qkrehdud11-blip/Balancing_Robot/mpu6050_report.html

# MPU6050 IMU 센서 기술 보고서

Balancing Robot Project — Basys3 FPGA (Xilinx) / Verilog HDL

InvenSense MPU-6050 · 6-Axis IMU · I²C Interface

### 목차

1. MPU6050 개요 및 주요 사양
2. 감도(Sensitivity)와 16384의 근거
3. 가속도계 데이터 해석
4. 자이로스코프 데이터 해석
5. I²C 통신 및 레지스터 맵
6. 초기화 시퀀스
7. 프로젝트 적용 현황
8. 현재 데이터 진단

## 1 MPU6050 개요 및 주요 사양

MPU6050은 InvenSense(현 TDK)에서 제조한 6축 IMU(Inertial Measurement Unit) 센서입니다. 3축 가속도계와 3축 자이로스코프를 하나의 패키지에 통합하고, I²C 인터페이스로 마이크로컨트롤러/FPGA와 통신합니다.

16-bit

ADC 해상도

400kHz

I²C 최대 속도

3.3V

동작 전압

6축

가속도 + 자이로

0x68

기본 I²C 주소

±2g~±16g

가속도 레인지

### 핀 구성

핀 | 이름 | 설명
VCC | 전원 | 3.3V (브레이크아웃 보드는 5V도 가능)
GND | 접지 | 공통 GND
SCL | I²C Clock | I²C 클럭 (풀업 4.7kΩ 필요)
SDA | I²C Data | I²C 데이터 (풀업 4.7kΩ 필요)
AD0 | 주소 선택 | GND → 0x68 / VCC → 0x69
INT | 인터럽트 | 데이터 레디 신호 (이 프로젝트 미사용)
XDA, XCL | 보조 I²C | 외부 센서 연결용 (미사용)

## 2 감도(Sensitivity)와 16384의 근거

MPU6050의 가속도계는 16비트 부호있는 정수(signed 16-bit)로 값을 출력합니다. 이 숫자가 실제 물리량(g)으로 변환되는 비율을 감도(Sensitivity Scale Factor)라고 합니다.

### 계산 원리

16-bit signed 정수 범위 : -32768 ~ +32767

양의 최대값 = 2^15 = 32768

±2g 레인지 선택 시:

Sensitivity = 32768 ÷ 2 (g) = 16384 LSB/g

→ 1g(중력가속도)가 인가되면 ADC 출력 = 16384

// LSB = Least Significant Bit, 즉 최솟값 1단위

### 레인지별 감도 비교

가속도 레인지 | Sensitivity | ACCEL_CONFIG
±2g (기본값) | 16384 LSB/g | AFS_SEL = 0b00
±4g | 8192 LSB/g | AFS_SEL = 0b01
±8g | 4096 LSB/g | AFS_SEL = 0b10
±16g | 2048 LSB/g | AFS_SEL = 0b11

자이로 레인지 | Sensitivity | GYRO_CONFIG
±250°/s (기본값) | 131 LSB/°/s | FS_SEL = 0b00
±500°/s | 65.5 LSB/°/s | FS_SEL = 0b01
±1000°/s | 32.8 LSB/°/s | FS_SEL = 0b10
±2000°/s | 16.4 LSB/°/s | FS_SEL = 0b11

결론: 이 프로젝트는 ACCEL_CONFIG/GYRO_CONFIG를 설정하지 않아 기본값 사용 중.
가속도 ±2g → Sensitivity = 16384 LSB/g
자이로 ±250°/s → Sensitivity = 131 LSB/(°/s)

### 실제값 변환 공식

실제 가속도 (g) = ADC값 ÷ 16384

실제 각속도 (°/s) = ADC값 ÷ 131

예시: AZ = 16120 → 16120 ÷ 16384 ≈ 0.984g (평지 기준 약 1g, 정상)

예시: GX = 131 → 131 ÷ 131 ≈ 1.0°/s

## 3 가속도계 데이터 해석

가속도계는 중력(g)을 포함한 선형 가속도를 측정합니다. 정지 상태에서도 중력(1g)이 측정되므로, 이를 기준으로 자세를 판단할 수 있습니다.

### 평지 정치 시 이상값

상태 | AX | AY | AZ | 설명
평지 정치 (이상) | 0 | 0 | +16384 | 중력이 Z축 방향으로만 작용
X축으로 5° 기울음 | ±1428 | ~0 | ~16320 | sin(5°)×16384 ≈ 1428
X축으로 90° 기울음 | ±16384 | ~0 | ~0 | 중력이 X축 방향으로 작용
완전히 뒤집힘 | ~0 | ~0 | -16384 | 중력이 -Z 방향
자유낙하 | 0 | 0 | 0 | 무중력 상태 (모든 축 0)

### 기울기 각도 계산

θ_x = arctan(AX / AZ) × (180 / π)

θ_y = arctan(AY / AZ) × (180 / π)

예시: AX=1471, AZ=16120

θ_x = arctan(1471 / 16120) = arctan(0.0912) ≈ 5.2°

// 가속도계만으로 계산한 각도 → 노이즈에 민감하므로 자이로와 상호 보완 필요

## 4 자이로스코프 데이터 해석

자이로스코프는 각속도(°/s, degree per second)를 측정합니다. 정지 상태에서는 0에 가까운 값이 나와야 하며, 회전 중에는 회전 속도에 비례한 값이 출력됩니다.

131

LSB per °/s (±250°/s)

±250°/s

기본 측정 범위

~50

정지 시 허용 노이즈 (LSB)

### 가속도계 vs 자이로스코프 비교

항목 | 가속도계 | 자이로스코프
측정 대상 | 선형 가속도 (중력 포함) | 각속도 (회전 속도)
정지 시 | AZ ≈ 16384 (중력), AX/AY ≈ 0 | GX/GY/GZ ≈ 0
장점 | 절대 각도 계산 가능 (중력 기준) | 빠른 응답, 단기 정확도 높음
단점 | 진동·충격에 민감, 노이즈 큼 | 드리프트(시간 지남에 따라 오차 누적)
균형 로봇 사용 | 기준 각도 보정용 | 실시간 각속도 제어용

균형 로봇 제어 전략: 가속도계 각도(절대 기준) + 자이로 각속도(빠른 반응)를 상보 필터(Complementary Filter) 또는 칼만 필터로 융합하여 안정적인 각도 추정이 필요합니다.

## 5 I²C 통신 및 레지스터 맵

MPU6050은 I²C 슬레이브로 동작합니다. AD0 핀 레벨로 주소가 결정되며, 이 프로젝트에서는 AD0=GND(0x68)를 사용합니다.

### I²C 주소

7-bit 주소: 0x68 (AD0=GND) / 0x69 (AD0=VCC)

쓰기 주소 (8-bit): 0xD0 → { 0x68, 1'b0 }

읽기 주소 (8-bit): 0xD1 → { 0x68, 1'b1 }

### 주요 레지스터 맵

주소 | 레지스터명 | 기본값 | 설명
0x19 | SMPLRT_DIV | 0x00 | 샘플링 레이트 분주기 (기본: 8kHz÷1 = 8kHz)
0x1A | CONFIG | 0x00 | DLPF(디지털 저역 통과 필터) 설정
0x1B | GYRO_CONFIG | 0x00 | 자이로 레인지: 0x00=±250°/s
0x1C | ACCEL_CONFIG | 0x00 | 가속도 레인지: 0x00=±2g
0x3B | ACCEL_XOUT_H | - | 가속도 X축 상위 바이트 (burst read 시작점)
0x3C | ACCEL_XOUT_L | - | 가속도 X축 하위 바이트
0x3D~0x40 | ACCEL_Y/Z | - | 가속도 Y, Z축 (각 2바이트)
0x41~0x42 | TEMP_OUT | - | 온도 센서 (이 프로젝트 미사용)
0x43~0x48 | GYRO_X/Y/Z | - | 자이로 X, Y, Z축 (각 2바이트)
0x6B | PWR_MGMT_1 | 0x40 | 슬립 모드 제어. 기본값 0x40=슬립 ON → 0x00으로 초기화 필요
0x75 | WHO_AM_I | 0x68 | 칩 ID 확인용 (항상 0x68 반환)

### Burst Read 순서 (0x3B~0x48, 14바이트)

Byte 0: ACCEL_XOUT_H │ Byte 1: ACCEL_XOUT_L → AX = {Byte0, Byte1}

Byte 2: ACCEL_YOUT_H │ Byte 3: ACCEL_YOUT_L → AY = {Byte2, Byte3}

Byte 4: ACCEL_ZOUT_H │ Byte 5: ACCEL_ZOUT_L → AZ = {Byte4, Byte5}

Byte 6: TEMP_OUT_H │ Byte 7: TEMP_OUT_L → (skip)

Byte 8: GYRO_XOUT_H │ Byte 9: GYRO_XOUT_L → GX = {Byte8, Byte9}

Byte 10: GYRO_YOUT_H │ Byte 11: GYRO_YOUT_L → GY = {Byte10,Byte11}

Byte 12: GYRO_ZOUT_H │ Byte 13: GYRO_ZOUT_L → GZ = {Byte12,Byte13}

## 6 초기화 시퀀스

MPU6050은 기본적으로 슬립(Sleep) 모드로 부팅됩니다. 반드시 PWR_MGMT_1 레지스터를 0x00으로 설정해 슬립을 해제해야 데이터가 출력됩니다.

### 최소 초기화 (현재 프로젝트)

① 전원 인가 후 50ms 이상 대기

② I²C Write: 0x6B (PWR_MGMT_1) ← 0x00 // 슬립 해제, 내부 8MHz 클럭 사용

③ 이후 0x3B부터 14바이트 Burst Read 반복

### 권장 추가 초기화 (선택)

순서 | 레지스터 | 값 | 효과
1 | 0x6B | 0x00 | 슬립 해제 (필수)
2 | 0x1A | 0x03 | DLPF 활성화 (44Hz 차단, 노이즈 감소)
3 | 0x19 | 0x04 | 샘플레이트 200Hz (DLPF ON 시 1kHz÷(4+1))
4 | 0x1B | 0x08 | 자이로 레인지 ±500°/s (균형 로봇에 더 적합)

⚠ DLPF 추천: 균형 로봇은 모터 진동이 심합니다. DLPF(CONFIG=0x03, 44Hz 차단주파수)를 설정하면 고주파 노이즈가 크게 줄어 PID 제어가 안정적으로 됩니다.

## 7 프로젝트 적용 현황

### 모듈 구조

모듈 | 파일 | 역할 | 상태
I²C 마스터 | i2c_master.v | Write/Burst Read FSM, ACK/NACK 처리 | 완성
MPU 제어 | mpu6050_ctrl.v | 초기화 → 14byte Burst Read → 6축 파싱 | 완성
UART 디버그 | mpu6050_debug_uart.v | 10진수 부호 포함 포맷으로 PC 출력 (1Hz) | 완성
Bias 보정 | top.v | 256 샘플 평균으로 AX/AY/GX/GY/GZ bias 제거 | 완성
각도 계산 | angle_calc.v | accel+gyro 융합 각도 추정 | 미구현

### I²C 타이밍 (현재 설정)

tick 주기: 0.5ms (clk_divider, 2kHz)

I²C SCL: 각 상태 1 tick → SCL ≈ 1kHz

MPU6050 최대 I²C: 400kHz → 현재 1kHz는 충분히 안전

데이터 읽기 주기: 1000 tick × 0.5ms = 500ms (2Hz)

UART 출력 주기: 1초 (1Hz)

### Bias 교정 소요 시간

data_valid 주기: 500ms

교정 샘플 수: 256개

교정 완료 시간: 256 × 500ms = 128초 (약 2분 10초)

// led[2] (bias_done) 켜질 때까지 대기 필요

### 핀 할당

신호 | FPGA 핀 | Basys3 위치
i2c_sda | K17 | JC 헤더 JC1
i2c_scl | M18 | JC 헤더 JC2
uart_tx (PC) | A18 | USB-RS232 직결
reset | U18 | BTNC (중앙 버튼)

## 8 현재 데이터 진단

현재 moserial에서 확인된 값: AX=+01471 AY=? AZ=+16120 GX≈0 GY≈0 GZ≈0

AZ = 16120 — 정상. 이상값 16384 대비 오차 264 LSB ≈ 0.016g (공장 오차 수준)

GX/GY/GZ ≈ 0 — 정상. 정지 상태에서 각속도 0에 수렴

AX = 1471 — 확인 필요. 아래 원인 중 하나

가능한 원인 | 확인 방법 | 해결
Bias 교정 미완료 (2분 미경과) | led[2] (bias_done) 꺼져 있음 | Reset 후 2분 이상 평지에서 대기
실제 5° 기울어진 상태 | 보드를 수평계로 확인 | MPU6050 장착 각도 수정
교정 중 기울어져 있었음 | Reset 후 평지에서 재교정 | 평지 고정 후 Reset

⚠ 빠른 교정 확인 방법:
mpu6050_ctrl.v의 READ_PERIOD_TICKS를 100으로 줄이면 교정 시간이 128초 → 약 13초로 단축됩니다.

### 균형 로봇 목표값

조건 | AX 목표 | AZ 목표 | 의미
로봇 직립 균형 | ≈ 0 | ≈ 16384 | 완전 수직 상태
PID 에러 입력 | error = AX_measured - 0 | | AX가 PID setpoint 편차
모터 구동 임계 | |AX| > 200 | - | 이보다 크면 모터 보정 개입

MPU6050 기술 보고서 · Balancing Robot Project (Basys3 FPGA) · 2026-04-15
InvenSense MPU-6050 Product Specification Rev 3.4 기준
