qkrehdud11-blip/Balancing_Robot/Balacing_Robot.srcs/sources_1/new/l298n.v

`timescale 1ns / 1ps
//////////////////////////////////////////////////////////////////////////////////
// Company: 
// Engineer: 
// 
// Create Date: 04/12/2026 11:40:38 PM
// Design Name: 
// Module Name: l298n
// Project Name: 
// Target Devices: 
// Tool Versions: 
// Description: 
// 
// Dependencies: 
// 
// Revision:
// Revision 0.01 - File Created
// Additional Comments:
// 
//////////////////////////////////////////////////////////////////////////////////


module l298n(

    );
endmodule
