qkrehdud11-blip/Balancing_Robot/(commit log)

2026-04-12 Add claude.md on gitignore Add pid.v
2026-04-14 test i2c burst
2026-04-14 Address Uart + Bluetooth Echo
2026-04-15 Add Encoder
2026-04-15 PID Ctrl, MPU 6050 Debug
2026-04-16 PID Progress
